Caleb-eng-tech/lucid_light_pcb/Test_PCB_design/Test_PCB_design.step

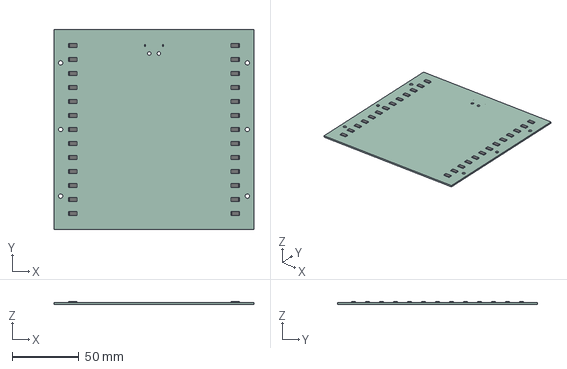
[picture p1: CAD file, 2026-09-21]
Test_PCB_design/Test_PCB_design.step
150.0 x 150.0 x 2.16 mm
R_2512_6332Metric x 26
TesB9CD_PCB
