Caleb-eng-tech/lucid_light_pcb/(list of files, drawings)

Other design files:
Altium_PCB/0.1 Ω, 1 W, 1206.SchLib
Altium_PCB/470pF_12010_3225.SchLib
Altium_PCB/Central_PCB/AS150UPB-M_2+4..PcbLib
Altium_PCB/Central_PCB/AS150UPB-M_2+4.SchLib
Altium_PCB/Central_PCB/Imported AS150UPB_2+4/AS150UPB_2+4.PrjPcb
Altium_PCB/Central_PCB/Imported AS150UPB_2+4/AS150UPW_2+4_M_G_Y.SchLib
Altium_PCB/Central_PCB/WIRE_Solder_8AWG.PcbLib
Altium_PCB/LED_BUK_3.SchDoc
Altium_PCB/LED_BUK_4.SchDoc
Altium_PCB/LED_BUK_5.SchDoc
Altium_PCB/LED_BUK_6.SchDoc
Altium_PCB/LUCID_LIGHT_Custom_LED.SchLib
Altium_PCB/LUCID_LIGHT_Custom_Mosfet.PcbLib
Altium_PCB/LUCID_LIGHT_Custom_Mosfet.SchLib
Altium_PCB/LUCID_LIGHT_PCB_Outer.PcbDoc
Altium_PCB/Power_Connector.SchDoc
Altium_PCB/ul_MAL214658471E3/Altium/MAL214658471E3/MAL214658471E3.PcbLib
Altium_PCB_Central/Imported AS150UPB_2+4/AS150UPW_2+4_M_G_Y.PcbLib
Altium_PCB_Central/LED_Central.SchDoc
Altium_PCB_Central/LUICD_LIGHT_PCB_Central.PcbDoc
Altium_PCB_Central/LUICD_LIGHT_PCB_Central.PrjPcb
Altium_PCB_Central/WIRE_Solder_8AWG.SchLib
Altium_PCB_Outer/0.22 µF, 25 V, X7R, 0603.SchLib
Altium_PCB_Outer/2.2 µF, 16 V, X7R, 0805.SchLib
Altium_PCB_Outer/12A, fast-acting, 125V DC rating.SchLib
Altium_PCB_Outer/20A_Fuse.SchLib
Altium_PCB_Outer/47 µH inductor.SchLib
Altium_PCB_Outer/47.5 kΩ.SchLib
Altium_PCB_Outer/Imported Bridgelux_V22_Custom/Bridgelux_V22_Custom.PrjPcb
Altium_PCB_Outer/Imported Bridgelux_V22_Custom/LED_PCB_Large_Custom.PcbLib
Altium_PCB_Outer/L_YSPI1365_470M.PcbLib
Altium_PCB_Outer/LED_BUK_1.SchDoc
Altium_PCB_Outer/LED_BUK_2.SchDoc
Altium_PCB_Outer/LED_BUK_3.SchDoc
Altium_PCB_Outer/LED_BUK_4.SchDoc
Altium_PCB_Outer/LED_BUK_5.SchDoc
Altium_PCB_Outer/LED_BUK_6.SchDoc
Altium_PCB_Outer/LUCID_LIGHT_Passives.PcbLib
Altium_PCB_Outer/LUCID_LIGHT_PCB.PrjPcb
Altium_PCB_Outer/LUCID_LIGHT_PCB_Outer.PcbDoc
Altium_PCB_Outer/LUCID_LIGHT_PCB_Outer.PrjPcb
Altium_PCB_Outer/Power_Connector.SchDoc
Altium_PCB_Outer/ul_MAL214658471E3/Altium/MAL214658471E3/MAL214658471E3.SchLib
Altium_PCB_Outer_PWM_Test/LED_BUK_2.SchDoc
Altium_PCB_Outer_PWM_Test/LED_BUK_5.SchDoc
Altium_PCB_Outer_PWM_Test/LUCID_Connectors.PcbLib
Altium_PCB_Outer_PWM_Test/LUCID_Connectors.SchLib
Altium_PCB_Outer_PWM_Test/LUCID_LIGHT_PCB_Outer.PcbDoc
Altium_PCB_Outer_PWM_Test/Power_Connector.SchDoc
Altium_PCB_Outer_PWM_Test/ul_MAX20078ATE-V-T/Altium/MAX20078ATEV&plus_T.SchLib
KiCad_PCB/Imported AS150U_Custom/AS150U_Custom.PrjPcb
KiCad_PCB/Imported AS150U_Custom/AS150U_Custom.SchLib
KiCad_PCB/Imported AS150U_Custom/LED_PCB_Large_Custom.PcbLib
