Caleb-eng-tech/lucid_light_pcb/Test_PCB_design/LED_PCB_Large/LED_PCB_Large.kicad_pcb

## KiCad design Test_PCB_design/LED_PCB_Large/LED_PCB_Large.kicad_pcb (2026-09-23)

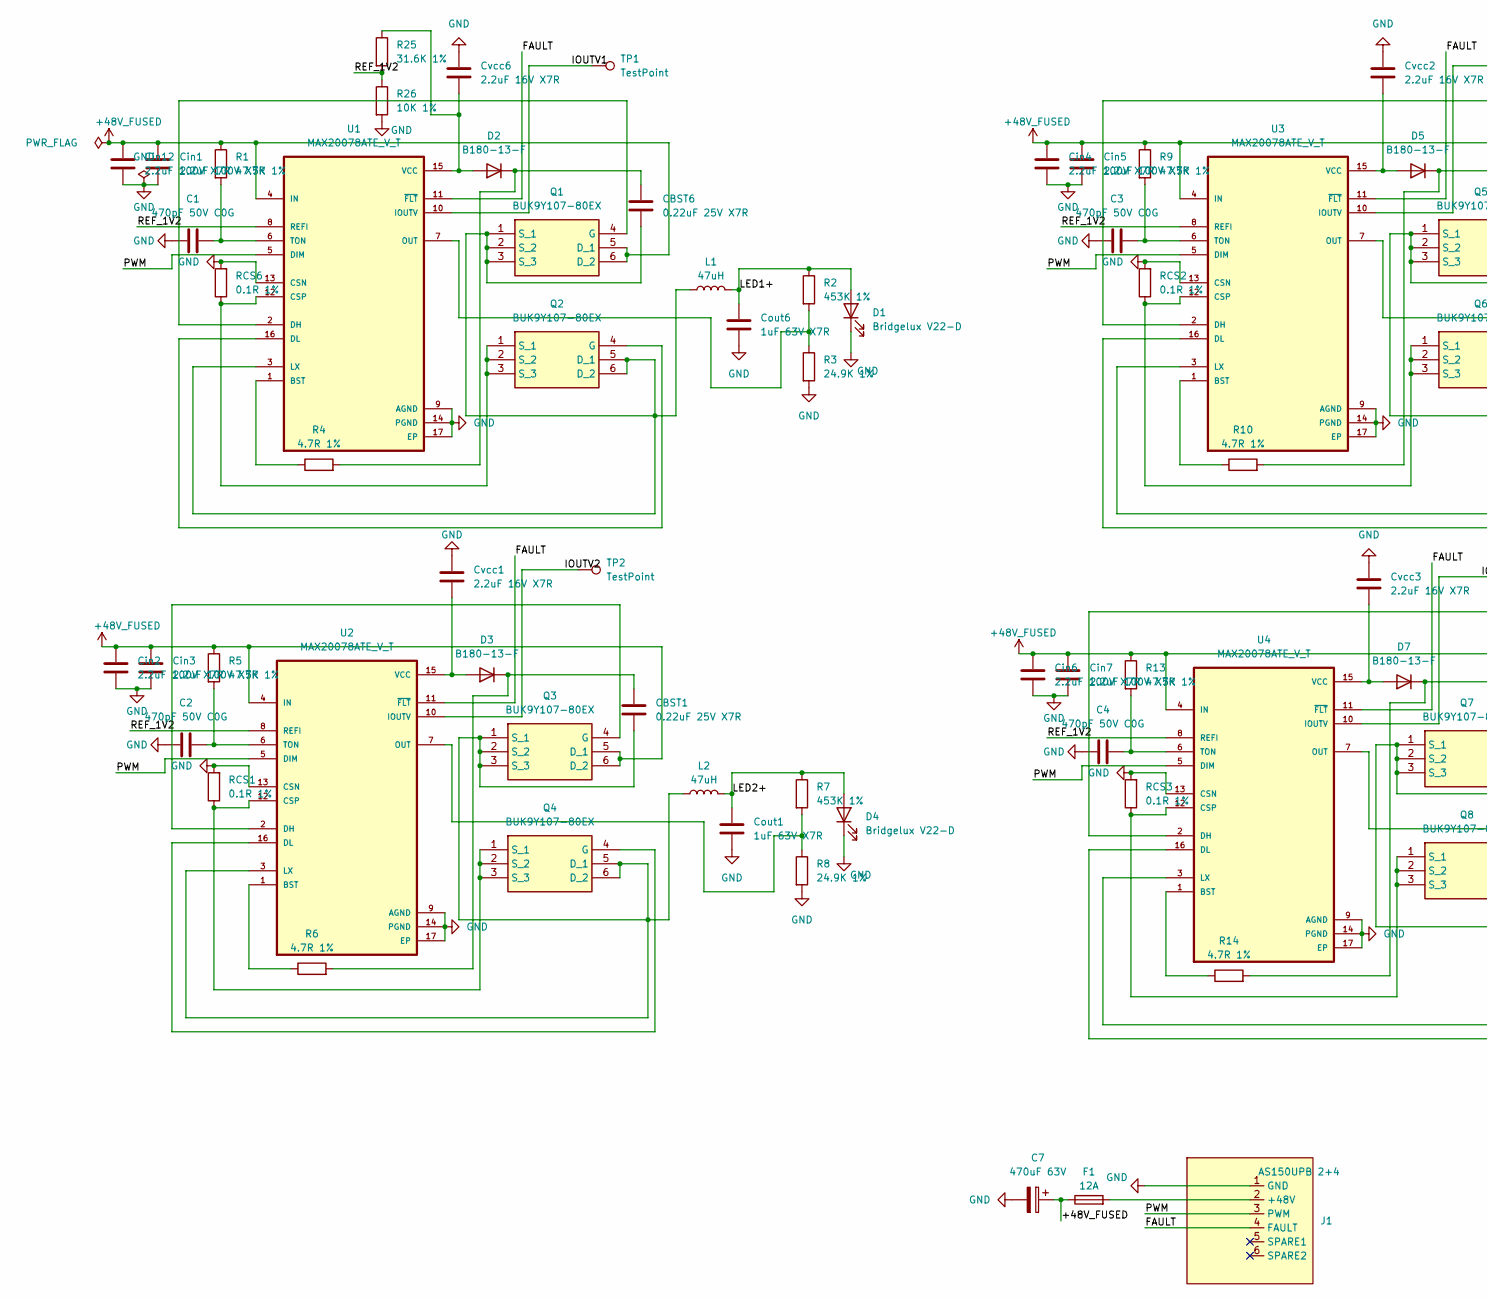
[picture p2: schematic LED_PCB_Large.kicad_sch, part in row 1, column 1]

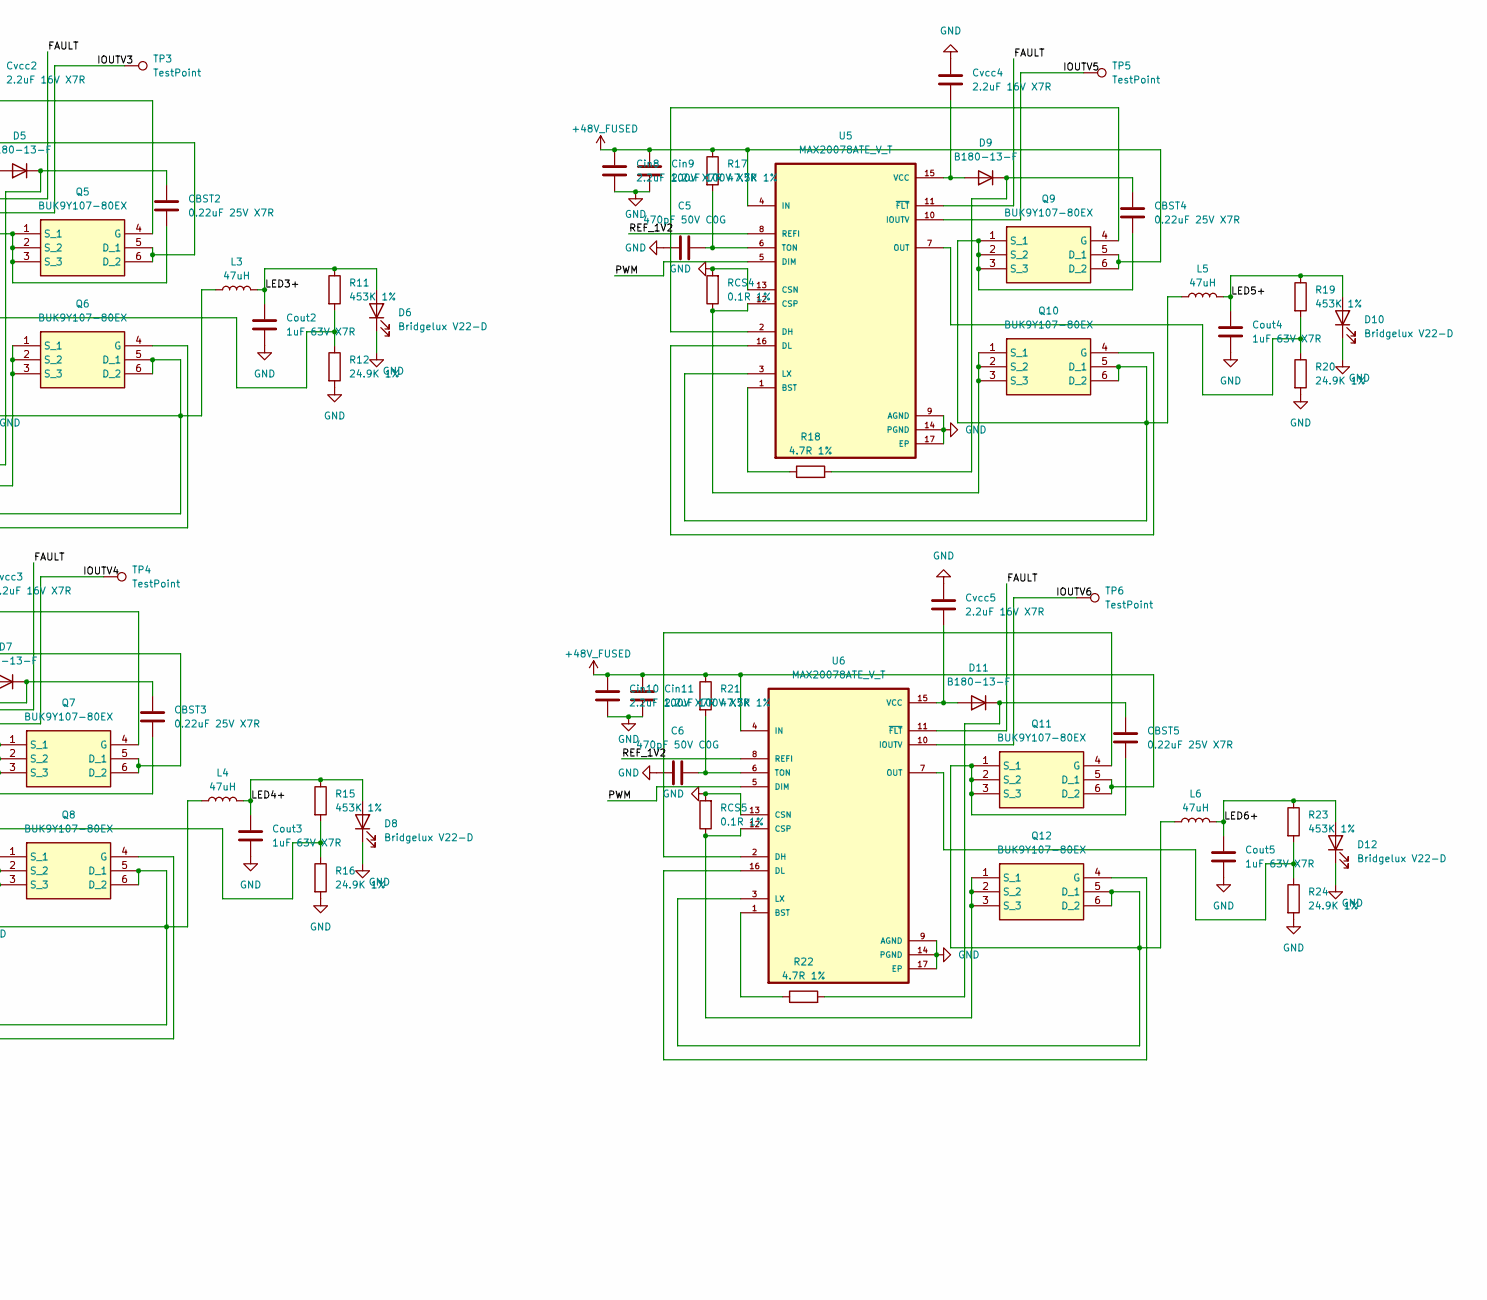
[picture p3: schematic LED_PCB_Large.kicad_sch, part in row 1, column 2]

Parts:
C1, C2, C3, C4, C5, C6: 470pF 50V C0G; C_0603_1608Metric
C7: 470uF 63V; CP_Radial_D12.5mm_P5.00mm
CBST1, CBST2, CBST3, CBST4, CBST5, CBST6: 0.22uF 25V X7R; C_0603_1608Metric
Cin1, Cin2, Cin3, Cin4, Cin5, Cin6, Cin7, Cin8, Cin9, Cin10, Cin11, Cin12: 2.2uF 100V X7R; C_1210_3225Metric
Cout1, Cout2, Cout3, Cout4, Cout5, Cout6: 1uF 63V X7R; C_0805_2012Metric
Cvcc1, Cvcc2, Cvcc3, Cvcc4, Cvcc5, Cvcc6: 2.2uF 16V X7R; C_0805_2012Metric
D1, D4, D6, D8, D10, D12: Bridgelux V22-D; Bridgelux_V22_Custom
D2, D3, D5, D7, D9, D11: B180-13-F; D_SMA
F1: 12A; 0454012.MR
J1: AS150UPB 2+4; AS150UPB_2+4
L1, L2, L3, L4, L5, L6: 47uH; L_Coilcraft_MSS1278T-XXX
Q1, Q2, Q3, Q4, Q5, Q6, Q7, Q8, Q9, Q10, Q11, Q12: BUK9Y107-80EX; PHPT61002NYCLHX; Manufacturer_Part_Number BUK9Y107-80EX; Mouser Part Number 771-BUK9Y107-80EX
R1, R5, R9, R13, R17, R21: 47.5K 1%; R_0603_1608Metric
R2, R7, R11, R15, R19, R23: 453K 1%; R_0603_1608Metric
R3, R8, R12, R16, R20, R24: 24.9K 1%; R_0603_1608Metric
R4, R6, R10, R14, R18, R22: 4.7R 1%; R_0603_1608Metric
R25: 31.6K 1%; R_0603_1608Metric
R26: 10K 1%; R_0603_1608Metric
RCS1, RCS2, RCS3, RCS4, RCS5, RCS6: 0.1R 1%; R_1206_3216Metric
TP1, TP2, TP3, TP4, TP5, TP6: TestPoint; TestPoint_Pad_D1.0mm
U1, U2, U3, U4, U5, U6: MAX20078ATE_V_T; QFN50P300X300X80-17N

Connections:
+48V_FUSED: C7.1, Cin1.1, Cin2.1, Cin3.1, Cin4.1, Cin5.1, Cin6.1, Cin7.1, Cin8.1, Cin9.1, Cin10.1, Cin11.1, Cin12.1, F1.1, Q1.5 (D_1), Q1.6 (D_2), Q3.5 (D_1), Q3.6 (D_2), Q5.5 (D_1), Q5.6 (D_2), Q7.5 (D_1), Q7.6 (D_2), Q9.5 (D_1), Q9.6 (D_2), Q11.5 (D_1), Q11.6 (D_2), R1.1, R5.1, R9.1, R13.1, R17.1, R21.1, U1.4 (IN), U2.4 (IN), U3.4 (IN), U4.4 (IN), U5.4 (IN), U6.4 (IN)
/FAULT: J1.4 (FAULT), U1.11 (~FLT), U2.11 (~FLT), U3.11 (~FLT), U4.11 (~FLT), U5.11 (~FLT), U6.11 (~FLT)
/IOUTV1: TP1.1 (1_1), U1.10 (IOUTV)
/IOUTV2: TP2.1 (1_1), U2.10 (IOUTV)
/IOUTV3: TP3.1 (1_1), U3.10 (IOUTV)
/IOUTV4: TP4.1 (1_1), U4.10 (IOUTV)
/IOUTV5: TP5.1 (1_1), U5.10 (IOUTV)
/IOUTV6: TP6.1 (1_1), U6.10 (IOUTV)
/LED1+: Cout6.1, D1.2 (A), L1.2, R2.1
/LED2+: Cout1.1, D4.2 (A), L2.2, R7.1
/LED3+: Cout2.1, D6.2 (A), L3.2, R11.1
/LED4+: Cout3.1, D8.2 (A), L4.2, R15.1
/LED5+: Cout4.1, D10.2 (A), L5.2, R19.1
/LED6+: Cout5.1, D12.2 (A), L6.2, R23.1
/PWM: J1.3 (PWM), U1.5 (DIM), U2.5 (DIM), U3.5 (DIM), U4.5 (DIM), U5.5 (DIM), U6.5 (DIM)
/REF_1V2: R25.2, R26.1, U1.8 (REFI), U2.8 (REFI), U3.8 (REFI), U4.8 (REFI), U5.8 (REFI), U6.8 (REFI)
GND: C1.1, C2.1, C3.1, C4.1, C5.1, C6.1, C7.2, Cin1.2, Cin2.2, Cin3.2, Cin4.2, Cin5.2, Cin6.2, Cin7.2, Cin8.2, Cin9.2, Cin10.2, Cin11.2, Cin12.2, Cout1.2, Cout2.2, Cout3.2, Cout4.2, Cout5.2, Cout6.2, Cvcc1.1, Cvcc2.1, Cvcc3.1, Cvcc4.1, Cvcc5.1, Cvcc6.1, D1.1 (K), D4.1 (K), D6.1 (K), D8.1 (K), D10.1 (K), D12.1 (K), J1.1 (GND), R3.2, R8.2, R12.2, R16.2, R20.2, R24.2, R26.2, RCS1.2, RCS2.2, RCS3.2, RCS4.2, RCS5.2, RCS6.2, U1.9 (AGND), U1.13 (CSN), U1.14 (PGND), U1.17 (EP), U2.9 (AGND), U2.13 (CSN), U2.14 (PGND), U2.17 (EP), U3.9 (AGND), U3.13 (CSN), U3.14 (PGND), U3.17 (EP), U4.9 (AGND), U4.13 (CSN), U4.14 (PGND), U4.17 (EP), U5.9 (AGND), U5.13 (CSN), U5.14 (PGND), U5.17 (EP), U6.9 (AGND), U6.13 (CSN), U6.14 (PGND), U6.17 (EP)
unnamed: Cvcc6.2, D2.2 (A), R25.1, U1.15 (VCC)
unnamed: CBST6.1, D2.1 (K), R4.2
unnamed: Cvcc1.2, D3.2 (A), U2.15 (VCC)
unnamed: CBST1.1, D3.1 (K), R6.2
unnamed: Cvcc2.2, D5.2 (A), U3.15 (VCC)
unnamed: CBST2.1, D5.1 (K), R10.2
unnamed: Cvcc3.2, D7.2 (A), U4.15 (VCC)
unnamed: CBST3.1, D7.1 (K), R14.2
unnamed: Cvcc4.2, D9.2 (A), U5.15 (VCC)
unnamed: CBST4.1, D9.1 (K), R18.2
unnamed: Cvcc5.2, D11.2 (A), U6.15 (VCC)
unnamed: CBST5.1, D11.1 (K), R22.2
unnamed: F1.2, J1.2 (+48V)
unnamed: Q1.4 (G), U1.2 (DH)
unnamed: CBST6.2, L1.1, Q1.1 (S_1), Q1.2 (S_2), Q1.3 (S_3), Q2.5 (D_1), Q2.6 (D_2), U1.3 (LX)
unnamed: Q2.4 (G), U1.16 (DL)
unnamed: Q2.1 (S_1), Q2.2 (S_2), Q2.3 (S_3), RCS6.1, U1.12 (CSP)
unnamed: Q3.4 (G), U2.2 (DH)
unnamed: CBST1.2, L2.1, Q3.1 (S_1), Q3.2 (S_2), Q3.3 (S_3), Q4.5 (D_1), Q4.6 (D_2), U2.3 (LX)
unnamed: Q4.4 (G), U2.16 (DL)
unnamed: Q4.1 (S_1), Q4.2 (S_2), Q4.3 (S_3), RCS1.1, U2.12 (CSP)
unnamed: Q5.4 (G), U3.2 (DH)
unnamed: CBST2.2, L3.1, Q5.1 (S_1), Q5.2 (S_2), Q5.3 (S_3), Q6.5 (D_1), Q6.6 (D_2), U3.3 (LX)
unnamed: Q6.4 (G), U3.16 (DL)
unnamed: Q6.1 (S_1), Q6.2 (S_2), Q6.3 (S_3), RCS2.1, U3.12 (CSP)
unnamed: Q7.4 (G), U4.2 (DH)
unnamed: CBST3.2, L4.1, Q7.1 (S_1), Q7.2 (S_2), Q7.3 (S_3), Q8.5 (D_1), Q8.6 (D_2), U4.3 (LX)
unnamed: Q8.4 (G), U4.16 (DL)
unnamed: Q8.1 (S_1), Q8.2 (S_2), Q8.3 (S_3), RCS3.1, U4.12 (CSP)
unnamed: Q9.4 (G), U5.2 (DH)
unnamed: CBST4.2, L5.1, Q9.1 (S_1), Q9.2 (S_2), Q9.3 (S_3), Q10.5 (D_1), Q10.6 (D_2), U5.3 (LX)
unnamed: Q10.4 (G), U5.16 (DL)
unnamed: Q10.1 (S_1), Q10.2 (S_2), Q10.3 (S_3), RCS4.1, U5.12 (CSP)
unnamed: Q11.4 (G), U6.2 (DH)
unnamed: CBST5.2, L6.1, Q11.1 (S_1), Q11.2 (S_2), Q11.3 (S_3), Q12.5 (D_1), Q12.6 (D_2), U6.3 (LX)
unnamed: Q12.4 (G), U6.16 (DL)
unnamed: Q12.1 (S_1), Q12.2 (S_2), Q12.3 (S_3), RCS5.1, U6.12 (CSP)
unnamed: R4.1, U1.1 (BST)
unnamed: R2.2, R3.1, U1.7 (OUT)
unnamed: C1.2, R1.2, U1.6 (TON)
unnamed: R6.1, U2.1 (BST)
unnamed: R7.2, R8.1, U2.7 (OUT)
unnamed: C2.2, R5.2, U2.6 (TON)
unnamed: R10.1, U3.1 (BST)
unnamed: R11.2, R12.1, U3.7 (OUT)
unnamed: C3.2, R9.2, U3.6 (TON)
unnamed: R14.1, U4.1 (BST)
unnamed: R15.2, R16.1, U4.7 (OUT)
unnamed: C4.2, R13.2, U4.6 (TON)
unnamed: R18.1, U5.1 (BST)
unnamed: R19.2, R20.1, U5.7 (OUT)
unnamed: C5.2, R17.2, U5.6 (TON)
unnamed: R22.1, U6.1 (BST)
unnamed: R23.2, R24.1, U6.7 (OUT)
unnamed: C6.2, R21.2, U6.6 (TON)

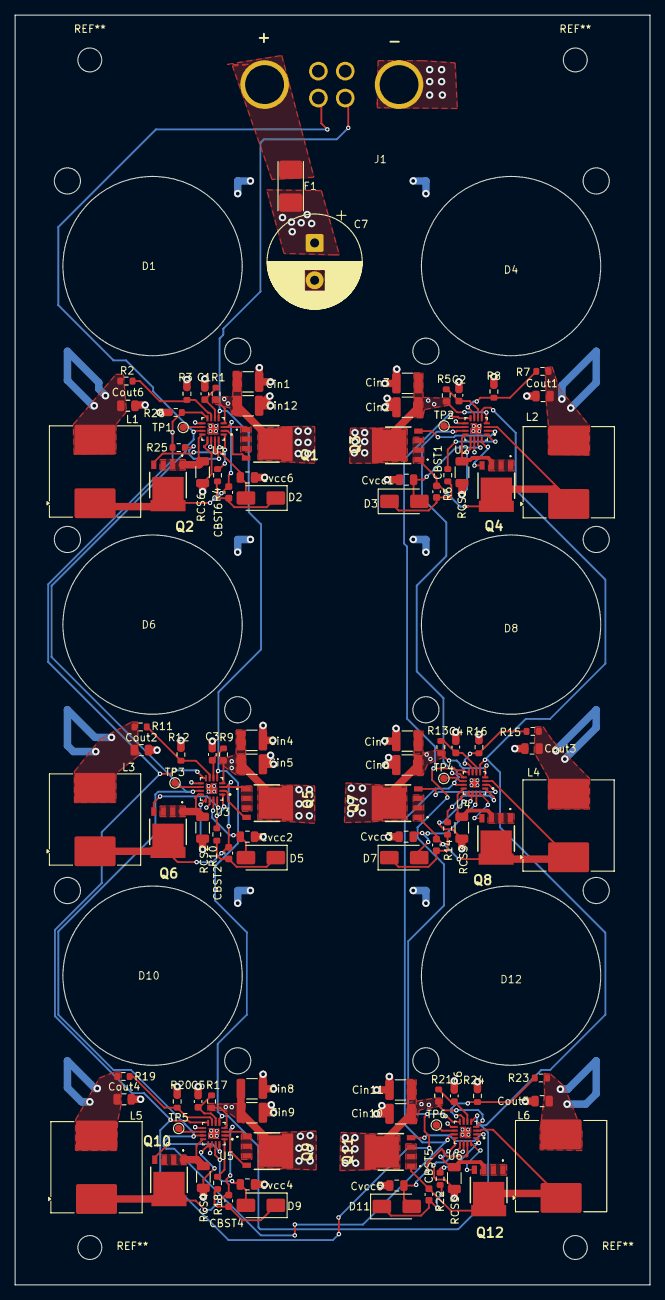
[picture p4: board LED_PCB_Large.kicad_pcb from above]

Board: 4 copper layers, 85.0 x 170.0 mm, 113 parts (0 on the bottom side), 72 nets.
