Caleb-eng-tech/lucid_light_pcb/Test_PCB_design/Test_PCB_design.kicad_pcb

## KiCad design Test_PCB_design/Test_PCB_design.kicad_pcb (2026-09-21)

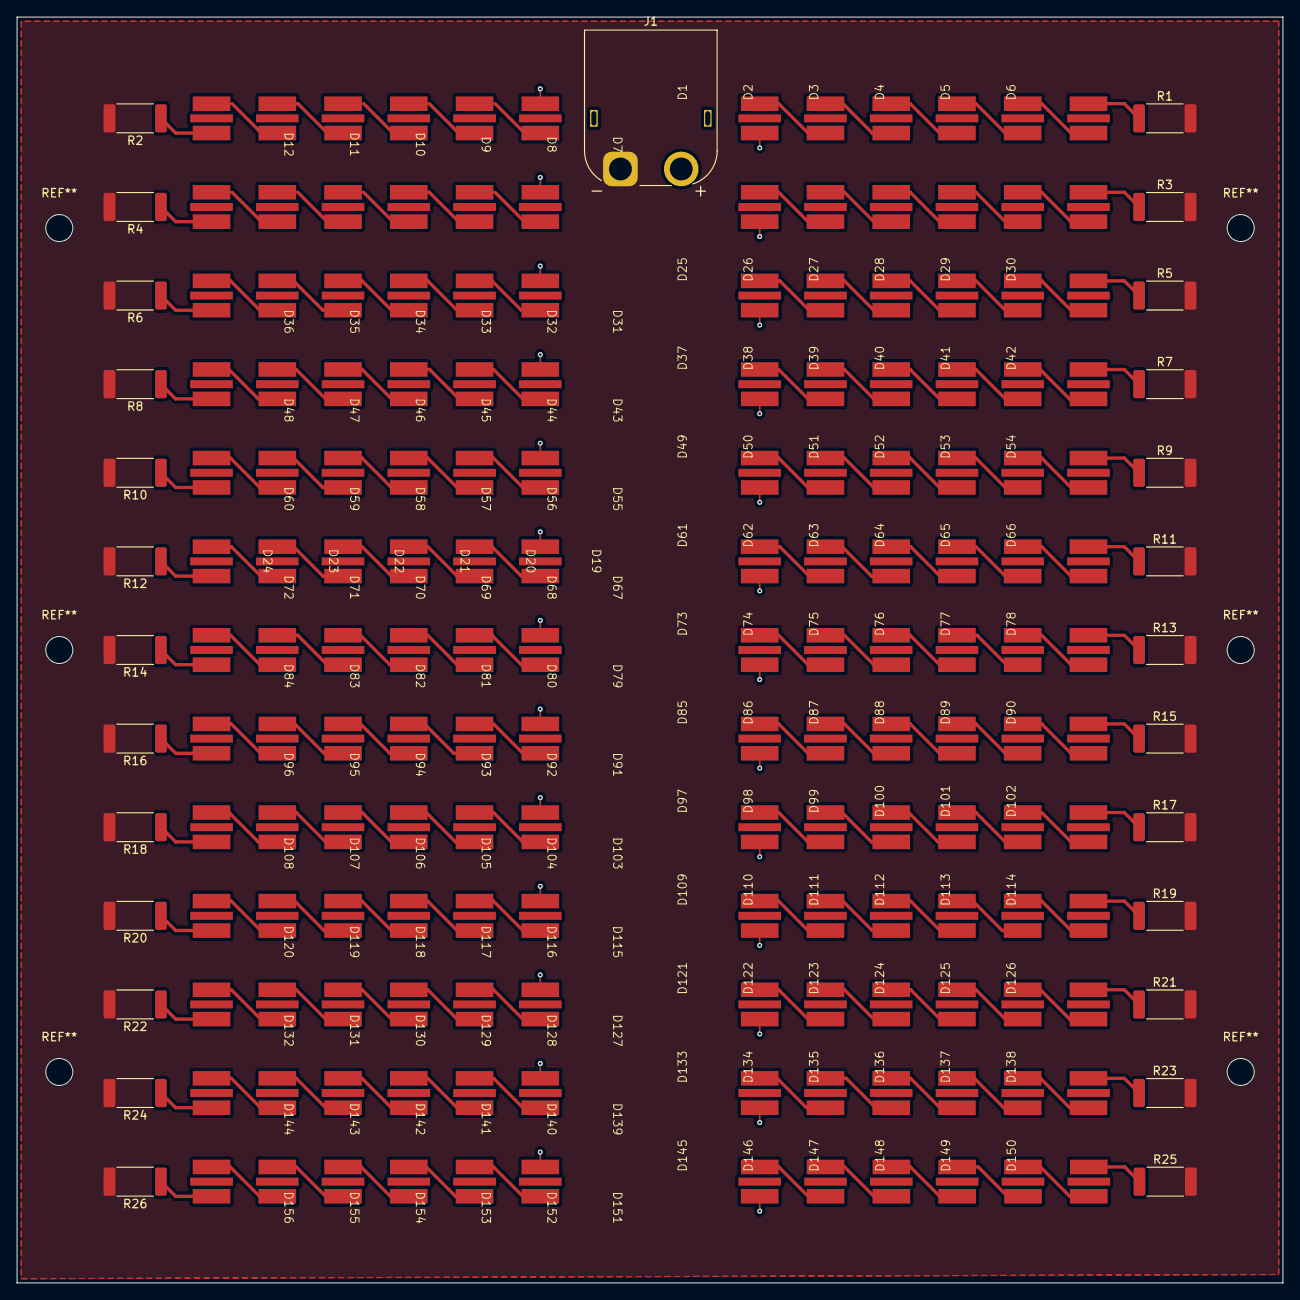
[picture p5: board Test_PCB_design.kicad_pcb from above]

Board: 2 copper layers, 150.0 x 150.0 mm, 183 parts (0 on the bottom side), 158 nets.

Parts:
D1, D2, D3, D4, D5, D6, D7, D8, D9, D10, D11, D12, D13, D14, D15, D16, D17, D18, D19, D20, D21, D22, D23, D24, D25, D26, D27, D28, D29, D30, D31, D32, D33, D34, D35, D36, D37, D38, D39, D40, D41, D42, D43, D44, D45, D46, D47, D48, D49, D50, D51, D52, D53, D54, D55, D56, D57, D58, D59, D60, D61, D62, D63, D64, D65, D66, D67, D68, D69, D70, D71, D72, D73, D74, D75, D76, D77, D78, D79, D80, D81, D82, D83, D84, D85, D86, D87, D88, D89, D90, D91, D92, D93, D94, D95, D96, D97, D98, D99, D100, D101, D102, D103, D104, D105, D106, D107, D108, D109, D110, D111, D112, D113, D114, D115, D116, D117, D118, D119, D120, D121, D122, D123, D124, D125, D126, D127, D128, D129, D130, D131, D132, D133, D134, D135, D136, D137, D138, D139, D140, D141, D142, D143, D144, D145, D146, D147, D148, D149, D150, D151, D152, D153, D154, D155, D156: Cree_JR5050C
J1: Conn_01x02_Pin; AMASS_XT60PW-M_1x02_P7.20mm_Horizontal
R1, R2, R3, R4, R5, R6, R7, R8, R9, R10, R11, R12, R13, R14, R15, R16, R17, R18, R19, R20, R21, R22, R23, R24, R25, R26: 2R; R_2512_6332Metric_Pad1.40x3.35mm_HandSolder

Connections:
/LED+: J1.1, R1.2, R2.2, R3.2, R4.2, R5.2, R6.2, R7.2, R8.2, R9.2, R10.2, R11.2, R12.2, R13.2, R14.2, R15.2, R16.2, R17.2, R18.2, R19.2, R20.2, R21.2, R22.2, R23.2, R24.2, R25.2, R26.2
/LED-: D1.1 (K), D7.1 (K), D13.1 (K), D19.1 (K), D25.1 (K), D31.1 (K), D37.1 (K), D43.1 (K), D49.1 (K), D55.1 (K), D61.1 (K), D67.1 (K), D73.1 (K), D79.1 (K), D85.1 (K), D91.1 (K), D97.1 (K), D103.1 (K), D109.1 (K), D115.1 (K), D121.1 (K), D127.1 (K), D133.1 (K), D139.1 (K), D145.1 (K), D151.1 (K), J1.2
unnamed: D1.2 (A), D2.1 (K)
unnamed: D2.2 (A), D3.1 (K)
unnamed: D3.2 (A), D4.1 (K)
unnamed: D4.2 (A), D5.1 (K)
unnamed: D5.2 (A), D6.1 (K)
unnamed: D6.2 (A), R1.1
unnamed: D7.2 (A), D8.1 (K)
unnamed: D8.2 (A), D9.1 (K)
unnamed: D10.2 (A), D11.1 (K)
unnamed: D9.2 (A), D10.1 (K)
unnamed: D11.2 (A), D12.1 (K)
unnamed: D12.2 (A), R2.1
unnamed: D13.2 (A), D14.1 (K)
unnamed: D14.2 (A), D15.1 (K)
unnamed: D15.2 (A), D16.1 (K)
unnamed: D16.2 (A), D17.1 (K)
unnamed: D17.2 (A), D18.1 (K)
unnamed: D18.2 (A), R3.1
unnamed: D19.2 (A), D20.1 (K)
unnamed: D20.2 (A), D21.1 (K)
unnamed: D21.2 (A), D22.1 (K)
unnamed: D22.2 (A), D23.1 (K)
unnamed: D23.2 (A), D24.1 (K)
unnamed: D24.2 (A), R4.1
unnamed: D25.2 (A), D26.1 (K)
unnamed: D26.2 (A), D27.1 (K)
unnamed: D27.2 (A), D28.1 (K)
unnamed: D28.2 (A), D29.1 (K)
unnamed: D29.2 (A), D30.1 (K)
unnamed: D30.2 (A), R5.1
unnamed: D31.2 (A), D32.1 (K)
unnamed: D32.2 (A), D33.1 (K)
unnamed: D33.2 (A), D34.1 (K)
unnamed: D34.2 (A), D35.1 (K)
unnamed: D35.2 (A), D36.1 (K)
unnamed: D36.2 (A), R6.1
unnamed: D37.2 (A), D38.1 (K)
unnamed: D38.2 (A), D39.1 (K)
unnamed: D39.2 (A), D40.1 (K)
unnamed: D40.2 (A), D41.1 (K)
unnamed: D41.2 (A), D42.1 (K)
unnamed: D42.2 (A), R7.1
unnamed: D43.2 (A), D44.1 (K)
unnamed: D44.2 (A), D45.1 (K)
unnamed: D45.2 (A), D46.1 (K)
unnamed: D46.2 (A), D47.1 (K)
unnamed: D47.2 (A), D48.1 (K)
unnamed: D48.2 (A), R8.1
unnamed: D49.2 (A), D50.1 (K)
unnamed: D50.2 (A), D51.1 (K)
unnamed: D51.2 (A), D52.1 (K)
unnamed: D52.2 (A), D53.1 (K)
unnamed: D53.2 (A), D54.1 (K)
unnamed: D54.2 (A), R9.1
unnamed: D55.2 (A), D56.1 (K)
unnamed: D56.2 (A), D57.1 (K)
unnamed: D57.2 (A), D58.1 (K)
unnamed: D58.2 (A), D59.1 (K)
unnamed: D59.2 (A), D60.1 (K)
unnamed: D60.2 (A), R10.1
unnamed: D61.2 (A), D62.1 (K)
unnamed: D62.2 (A), D63.1 (K)
unnamed: D63.2 (A), D64.1 (K)
unnamed: D64.2 (A), D65.1 (K)
unnamed: D65.2 (A), D66.1 (K)
unnamed: D66.2 (A), R11.1
unnamed: D67.2 (A), D68.1 (K)
unnamed: D68.2 (A), D69.1 (K)
unnamed: D69.2 (A), D70.1 (K)
unnamed: D70.2 (A), D71.1 (K)
unnamed: D71.2 (A), D72.1 (K)
unnamed: D72.2 (A), R12.1
unnamed: D73.2 (A), D74.1 (K)
unnamed: D74.2 (A), D75.1 (K)
unnamed: D75.2 (A), D76.1 (K)
unnamed: D76.2 (A), D77.1 (K)
unnamed: D77.2 (A), D78.1 (K)
unnamed: D78.2 (A), R13.1
unnamed: D79.2 (A), D80.1 (K)
unnamed: D80.2 (A), D81.1 (K)
unnamed: D81.2 (A), D82.1 (K)
unnamed: D82.2 (A), D83.1 (K)
unnamed: D83.2 (A), D84.1 (K)
unnamed: D84.2 (A), R14.1
unnamed: D85.2 (A), D86.1 (K)
unnamed: D86.2 (A), D87.1 (K)
unnamed: D87.2 (A), D88.1 (K)
unnamed: D88.2 (A), D89.1 (K)
unnamed: D89.2 (A), D90.1 (K)
unnamed: D90.2 (A), R15.1
unnamed: D91.2 (A), D92.1 (K)
unnamed: D92.2 (A), D93.1 (K)
unnamed: D93.2 (A), D94.1 (K)
unnamed: D94.2 (A), D95.1 (K)
unnamed: D95.2 (A), D96.1 (K)
unnamed: D96.2 (A), R16.1
unnamed: D97.2 (A), D98.1 (K)
unnamed: D98.2 (A), D99.1 (K)
unnamed: D100.2 (A), D101.1 (K)
unnamed: D99.2 (A), D100.1 (K)
unnamed: D101.2 (A), D102.1 (K)
unnamed: D102.2 (A), R17.1
unnamed: D103.2 (A), D104.1 (K)
unnamed: D104.2 (A), D105.1 (K)
unnamed: D105.2 (A), D106.1 (K)
unnamed: D106.2 (A), D107.1 (K)
unnamed: D107.2 (A), D108.1 (K)
unnamed: D108.2 (A), R18.1
unnamed: D109.2 (A), D110.1 (K)
unnamed: D110.2 (A), D111.1 (K)
unnamed: D111.2 (A), D112.1 (K)
unnamed: D112.2 (A), D113.1 (K)
unnamed: D113.2 (A), D114.1 (K)
unnamed: D114.2 (A), R19.1
unnamed: D115.2 (A), D116.1 (K)
unnamed: D116.2 (A), D117.1 (K)
unnamed: D117.2 (A), D118.1 (K)
unnamed: D118.2 (A), D119.1 (K)
unnamed: D119.2 (A), D120.1 (K)
unnamed: D120.2 (A), R20.1
unnamed: D121.2 (A), D122.1 (K)
unnamed: D122.2 (A), D123.1 (K)
unnamed: D123.2 (A), D124.1 (K)
unnamed: D124.2 (A), D125.1 (K)
unnamed: D125.2 (A), D126.1 (K)
unnamed: D126.2 (A), R21.1
unnamed: D127.2 (A), D128.1 (K)
unnamed: D128.2 (A), D129.1 (K)
unnamed: D129.2 (A), D130.1 (K)
unnamed: D130.2 (A), D131.1 (K)
unnamed: D131.2 (A), D132.1 (K)
unnamed: D132.2 (A), R22.1
unnamed: D133.2 (A), D134.1 (K)
unnamed: D134.2 (A), D135.1 (K)
unnamed: D135.2 (A), D136.1 (K)
unnamed: D136.2 (A), D137.1 (K)
unnamed: D137.2 (A), D138.1 (K)
unnamed: D138.2 (A), R23.1
unnamed: D139.2 (A), D140.1 (K)
unnamed: D140.2 (A), D141.1 (K)
unnamed: D141.2 (A), D142.1 (K)
unnamed: D142.2 (A), D143.1 (K)
unnamed: D143.2 (A), D144.1 (K)
unnamed: D144.2 (A), R24.1
unnamed: D145.2 (A), D146.1 (K)
unnamed: D146.2 (A), D147.1 (K)
unnamed: D147.2 (A), D148.1 (K)
unnamed: D148.2 (A), D149.1 (K)
unnamed: D149.2 (A), D150.1 (K)
unnamed: D150.2 (A), R25.1
unnamed: D151.2 (A), D152.1 (K)
unnamed: D152.2 (A), D153.1 (K)
unnamed: D153.2 (A), D154.1 (K)
unnamed: D154.2 (A), D155.1 (K)
unnamed: D155.2 (A), D156.1 (K)
unnamed: D156.2 (A), R26.1
