Caleb-eng-tech/lucid_light_pcb/(commit log)

2026-09-21 Kicad files
    [LED_PCB_Large.kicad_pcb, LED_PCB_Large.kicad_sch, Test_PCB_design.kicad_pcb, Test_PCB_design.kicad_sch, Test_PCB_design.step]
2026-09-21 updated LED1 with traces
    [LED_PCB_Large.kicad_pcb]
2026-09-22 updated with all LED traces
    [LED_PCB_Large.kicad_pcb]
2026-09-23 updated everything just need to check electrical traces to make sure they work.
    [LED_PCB_Large.kicad_pcb, LED_PCB_Large.kicad_sch]
2026-09-23 full done PCB (pre-pro-check)
    [LED_PCB_Large.kicad_pcb]
2026-10-16 Reorganize PCB project and add updated LED PCB design
2026-10-30 Add complete Altium PCB project and electrical design documentation
2026-10-30 Rename old KiCad folder to KiCad_PCB
2026-11-01 Add Central PCB power distribution design
2026-11-01 Separate Central and Outer Altium PCB projects
2026-11-01 Update Outer PCB for 2.1A LEDs and 20A fuse
2026-11-01 Move updated Outer PCB README to repository root
2026-11-01 Add Outer PCB documentation folder and revised README PDF
2026-11-01 Update Outer PCB with latest Altium changes
2026-11-02 Update Central and Outer PCB designs
2026-11-03 Add PWM test PCB as separate project
2026-11-04 Update central, outer, and PWM test PCB layouts
